Atlantis-xyc/smart-screen-t113/切片 68.png

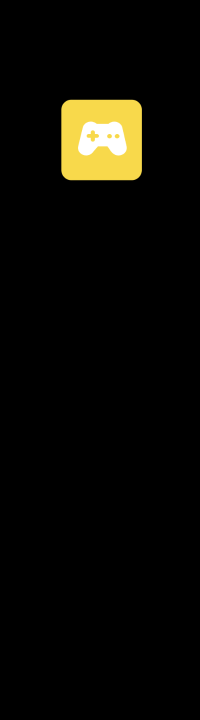
切片 68.png
