Atlantis-xyc/smart-screen-t113/素材/image (3).png

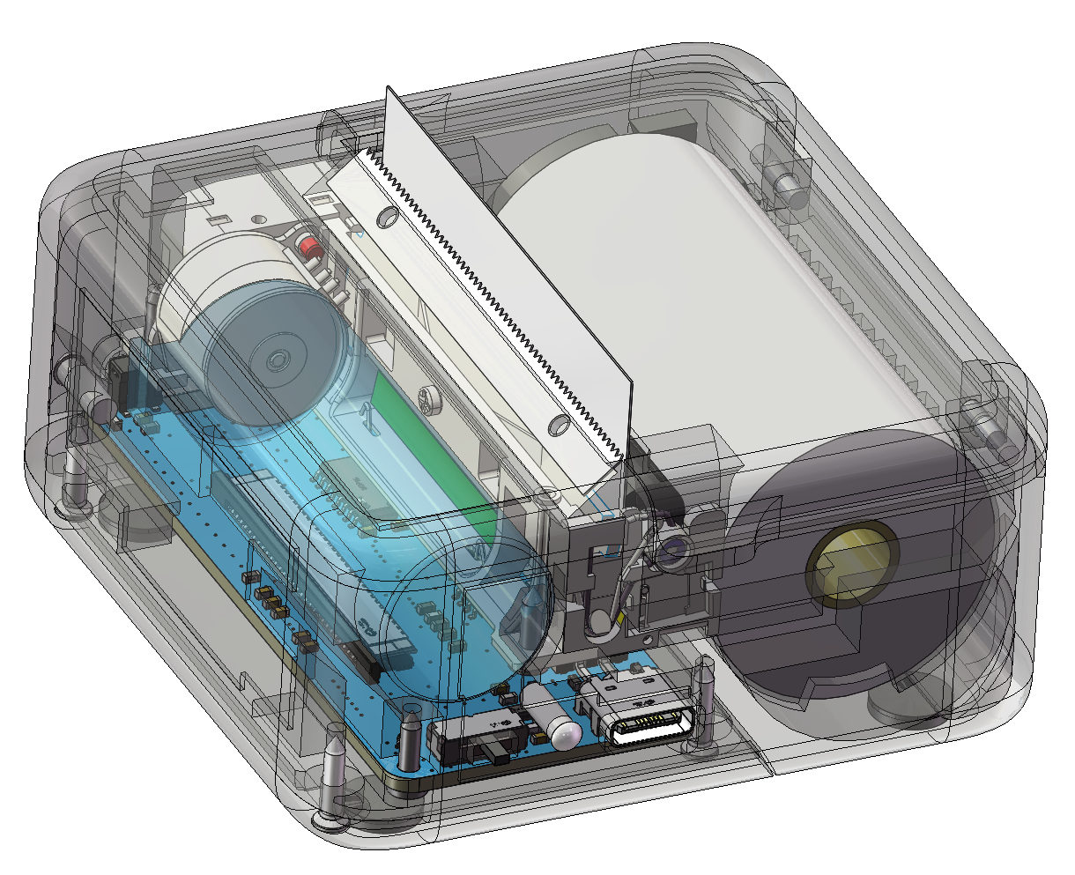
素材/image (3).png
