Atlantis-xyc/smart-screen-t113/素材/image (4).png

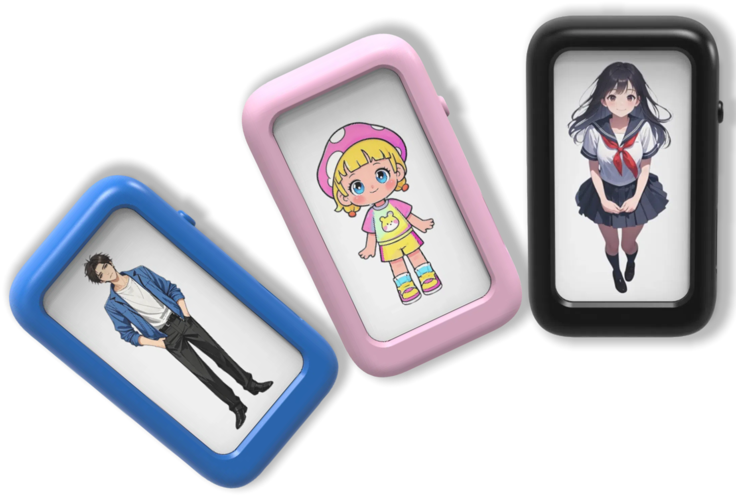
素材/image (4).png
