Atlantis-xyc/smart-screen-t113/素材/image (5).png

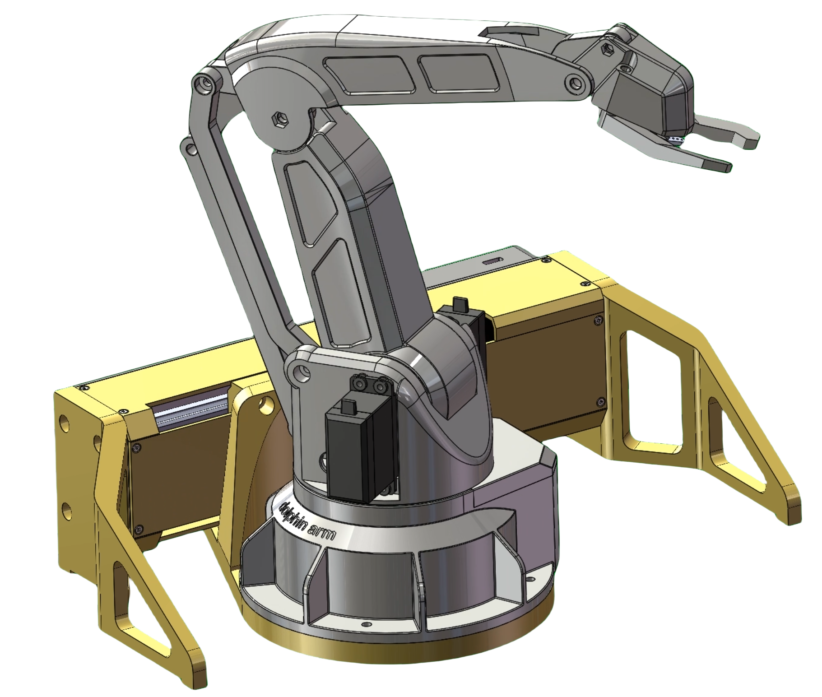
素材/image (5).png
