Atlantis-xyc/smart-screen-t113/素材/PixPin_2025-08-05_22-09-04.png

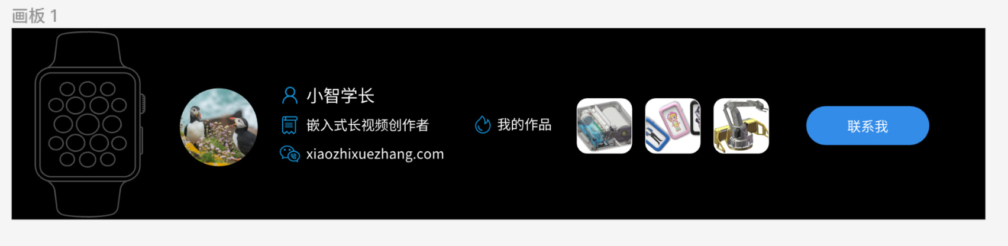
素材/PixPin_2025-08-05_22-09-04.png
