Atlantis-xyc/smart-screen-t113/素材/介绍.png

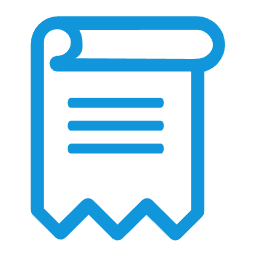
素材/介绍.png
