Atlantis-xyc/smart-screen-t113/素材/热门作品.png

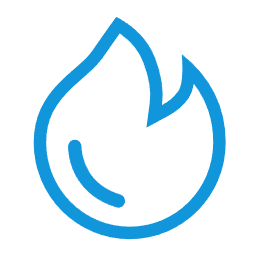
素材/热门作品.png
