Atlantis-xyc/smart-screen-t113/素材/用户.png

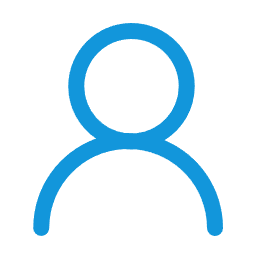
素材/用户.png
