Atlantis-xyc/smart-screen-t113/素材/联系方式.png

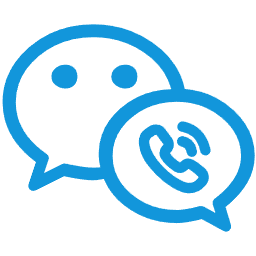
素材/联系方式.png
