Atlantis-xyc/smart-screen-t113/BOM_Board1_MIPI_PCB_2025-10-30.xlsx

No. | Quantity | Comment | Designator | Footprint | Value | Manufacturer Part | Manufacturer | Supplier Part | Supplier
1 | 22 | 100nF | C1,C12,C14,C15,C16,C17,C19,C21,C29,C30,C34,C36,C37,C38,C41,C63,C85,C86,C91,C116,C124,C135 | C0603 | 100nF | CC0603KRX7R9BB104 | YAGEO(国巨) | C14663 | LCSC
2 | 6 | 10uF | C9,C13,C27,C28,C31,C33 | C0603 | 10uF | CL10A106KP8NNNC | SAMSUNG(三星) | C19702 | LCSC
3 | 13 | 10uF | C64,C65,C107,C108,C109,C110,C111,C112,C115,C139,C143,C144,C145 | C0603 | 10uF | CL10A106MA8NRNC | SAMSUNG(三星) | C96446 | LCSC
4 | 3 | 470nF | C82,C83,C142 | C0603 | 470nF | CL10B474KA8NNNC | SAMSUNG(三星) | C1623 | LCSC
5 | 1 | 100pF | C87 | C0603 | 100pF | CL10C101JB8NNNC | SAMSUNG(三星) | C14858 | LCSC
6 | 1 | 2.2uF | C88 | C0603 | 2.2uF | CL10A225KO8NNNC | SAMSUNG(三星) | C23630 | LCSC
7 | 4 | 1uF | C119,C133,C138,C141 | C0603 | 1uF | CL10A105KB8NNNC | SAMSUNG(三星) | C15849 | LCSC
8 | 4 | 12pF | C120,C121,C122,C123 | C0603 | 12pF | CC0603FRNPO9BN120 | YAGEO(国巨) | C519482 | LCSC
9 | 1 | 22uF | C132 | C0603 | 22uF | CL10A226MQ8NRNC | SAMSUNG(三星) | C59461 | LCSC
10 | 1 | HC-1.25-2PWT | CN2 | CONN-SMD_2P-P1.25-HC-1.25-2PWT |  | HC-1.25-2PWT | HCTL(华灿天禄) | C2845379 | LCSC
11 | 2 | LMBR240FT1G | D22,D23 | SOD-123FL_L2.7-W1.8-LS3.8-RD |  | LMBR240FT1G | LRC(乐山无线电) | C383230 | LCSC
12 | 1 | FPC-05F-30PH20 | FPC2 | FPC-SMD_30P-P0.50_XUNPU_FPC-05F-30PH20 |  | FPC-05F-30PH20 | XUNPU(讯普) | C2856808 | LCSC
13 | 1 | AFC07-S06ECA-00 | FPC7 | FPC-SMD_P0.50-6P_LCS-SJ-H2.0 |  | AFC07-S06ECA-00 | JS(钜硕电子) | C262579 | LCSC
14 | 1 | GZ1608D601TF | L8 | L0603 | 600Ω | GZ1608D601TF | Sunlord(顺络) | C1002 | LCSC
15 | 1 | AN2051-245 | L10 | ANT2051 |  | AN2051-245 | rainsun(霖昱微) | C99727 | LCSC
16 | 1 | 10uH | L18 | IND-SMD_L2.0-W1.6 | 10uH | WPN201610H100MT | Sunlord(顺络) | C89132 | LCSC
17 | 4 | 2.2uH | L20,L21,L22,L23 | L0805 | 2.2uH | MGFL2012F2R2MT-LF | microgate(麦捷科技) | C281115 | LCSC
18 | 2 | NCD0603B1 | LED3,LED4 | LED0603-RD |  | NCD0603B1 | 国星光电 | C84266 | LCSC
19 | 1 | GMI4015P-2C-42db | MIC2 | MIC-TH_BD4.0-P1.40-D0.4-L-FD |  | GMI4015P-2C-42db | INGHAi(赢海) | C233292 | LCSC
20 | 10 | 10kΩ | R13,R52,R91,R93,R115,R120,R122,R124,R126,R145 | R0603 | 10kΩ | 0603WAF1002T5E | UNI-ROYAL(厚声) | C25804 | LCSC
21 | 1 | 10MΩ | R14 | R0603 | 10MΩ | 0603WAF1005T5E | UNI-ROYAL(厚声) | C7250 | LCSC
22 | 1 | 0Ω | R79 | R0603 | 0Ω | 0603WAF0000T5E | UNI-ROYAL(厚声) | C21189 | LCSC
23 | 1 | 33Ω | R90 | R0603 | 33Ω | 0603WAF330JT5E | UNI-ROYAL(厚声) | C23140 | LCSC
24 | 3 | 150kΩ | R107,R110,R152 | R0603 | 150kΩ | 0603WAF1503T5E | UNI-ROYAL(厚声) | C22807 | LCSC
25 | 1 | 680kΩ | R108 | R0603 | 680kΩ | 0603WAF6803T5E | UNI-ROYAL(厚声) | C25822 | LCSC
26 | 3 | 300kΩ | R109,R112,R153 | R0603 | 300kΩ | 0603WAF3003T5E | UNI-ROYAL(厚声) | C23024 | LCSC
27 | 1 | 200kΩ | R111 | R0603 | 200kΩ | 0603WAF2003T5E | UNI-ROYAL(厚声) | C25811 | LCSC
28 | 4 | 5.1kΩ | R113,R114,R141,R142 | R0603 | 5.1kΩ | 0603WAF5101T5E | UNI-ROYAL(厚声) | C23186 | LCSC
29 | 1 | 10Ω | R121 | R0603 | 10Ω | 0603WAF100JT5E | UNI-ROYAL(厚声) | C22859 | LCSC
30 | 1 | 240Ω | R123 | R0603 | 240Ω | 0603WAF2400T5E | UNI-ROYAL(厚声) | C23350 | LCSC
31 | 1 | 22Ω | R135 | R0603 | 22Ω | 0603WAF220JT5E | UNI-ROYAL(厚声) | C23345 | LCSC
32 | 2 | 20kΩ | R136,R149 | R0603 | 20kΩ | 0603WAF2002T5E | UNI-ROYAL(厚声) | C4184 | LCSC
33 | 1 | 100kΩ | R138 | R0603 | 100kΩ | 0603WAF1003T5E | UNI-ROYAL(厚声) | C25803 | LCSC
34 | 2 | 1kΩ | R146,R147 | R0603 | 1kΩ | 0603WAF1001T5E | UNI-ROYAL(厚声) | C21190 | LCSC
35 | 1 | 75Ω | R148 | R0603 | 75Ω | 0603WAF750JT5E | UNI-ROYAL(厚声) | C4275 | LCSC
36 | 3 | 10kΩ | RN1,RN2,RN3 | RES-ARRAY-SMD_0603-8P-L3.2-W1.6-BL | 10kΩ | 4D03WGJ0103T5E | UNI-ROYAL(厚声) | C29718 | LCSC
37 | 3 | TS-1088-AR02016 | SW1,SW2,SW5 | SW-SMD_L3.9-W3.0-P4.45 |  | TS-1088-AR02016 | XUNPU(讯普) | C720477 | LCSC
38 | 1 | T113_S3 | T1 | TQFP-128_L14.0-W14.0-P0.40-LS16.0-BL-EP6.4 |  |  |  |  | 全志
39 | 1 | W25N01GVZEIG | U1 | WSON-8_L8.0-W6.10-P1.27-BL-EP |  | W25N01GVZEIG | WINBOND(华邦) | C907680 | LCSC
40 | 1 | MX02 | U5 | MX02
41 | 1 | RTL8723DS模块 | U11 | WIFIM-SMD_44P-L12.0-W12.0-P0.90_RTL8723DS |  | RTL8723DS模块 |  | C2920724 | LCSC
42 | 11 | ESD5451N | U21,U33,U34,U35,U36,U37,U38,U41,U42,U49,U50 | X1-DFN1006-2_L1.0-W0.6-P0.65-BI |  | ESD5451N | TECH PUBLIC(台舟) | C2936977 | LCSC
43 | 1 | ZX-MX1.25-3PWT | U24 | CONN-SMD_3P-P1.25_MEGASTAR_ZX-MX1.25-3PWT |  | ZX-MX1.25-3PWT | Megastar(兆星) | C7430469 | LCSC
44 | 4 | SY8088AAC | U27,U28,U29,U54 | SOT-23-5_L3.0-W1.7-P0.95-LS2.8-BR |  | SY8088AAC | silergy(矽力杰) | C79313 | LCSC
45 | 1 | MT9201 | U52 | SOT-23-6_L2.9-W1.6-P0.95-LS2.8-BR |  | MT9201 | 西安航天民芯 | C182966 | LCSC
46 | 1 | LM4871 | U53 | SOIC-8_L4.9-W3.9-P1.27-LS6.0-BL |  | LM4871 | IDCHIP(英锐芯) | C7494970 | LCSC
47 | 2 | KH-TYPE-C-16P | USB9,USB10 | usb-c-smd_kh-type-c-16p |  | KH-TYPE-C-16P | kinghelm(金航标) | C709357 | LCSC
48 | 1 | XL2EL89COI-111YLC-24M | X1 | CRYSTAL-SMD_4P-L3.2-W2.5-BL |  | XL2EL89COI-111YLC-24M | YXC(扬兴晶振) | C5444545 | LCSC
49 | 1 | 32.768kHz | X2 | OSC-SMD_L3.2-W1.5 | 32.768kHz | X321532768KGD2SI | YXC(扬兴晶振) | C620155 | LCSC
