Atlantis-xyc/smart-screen-t113/SCH_Schematic_2026-05-21.pdf

T113S3

# 外围电容

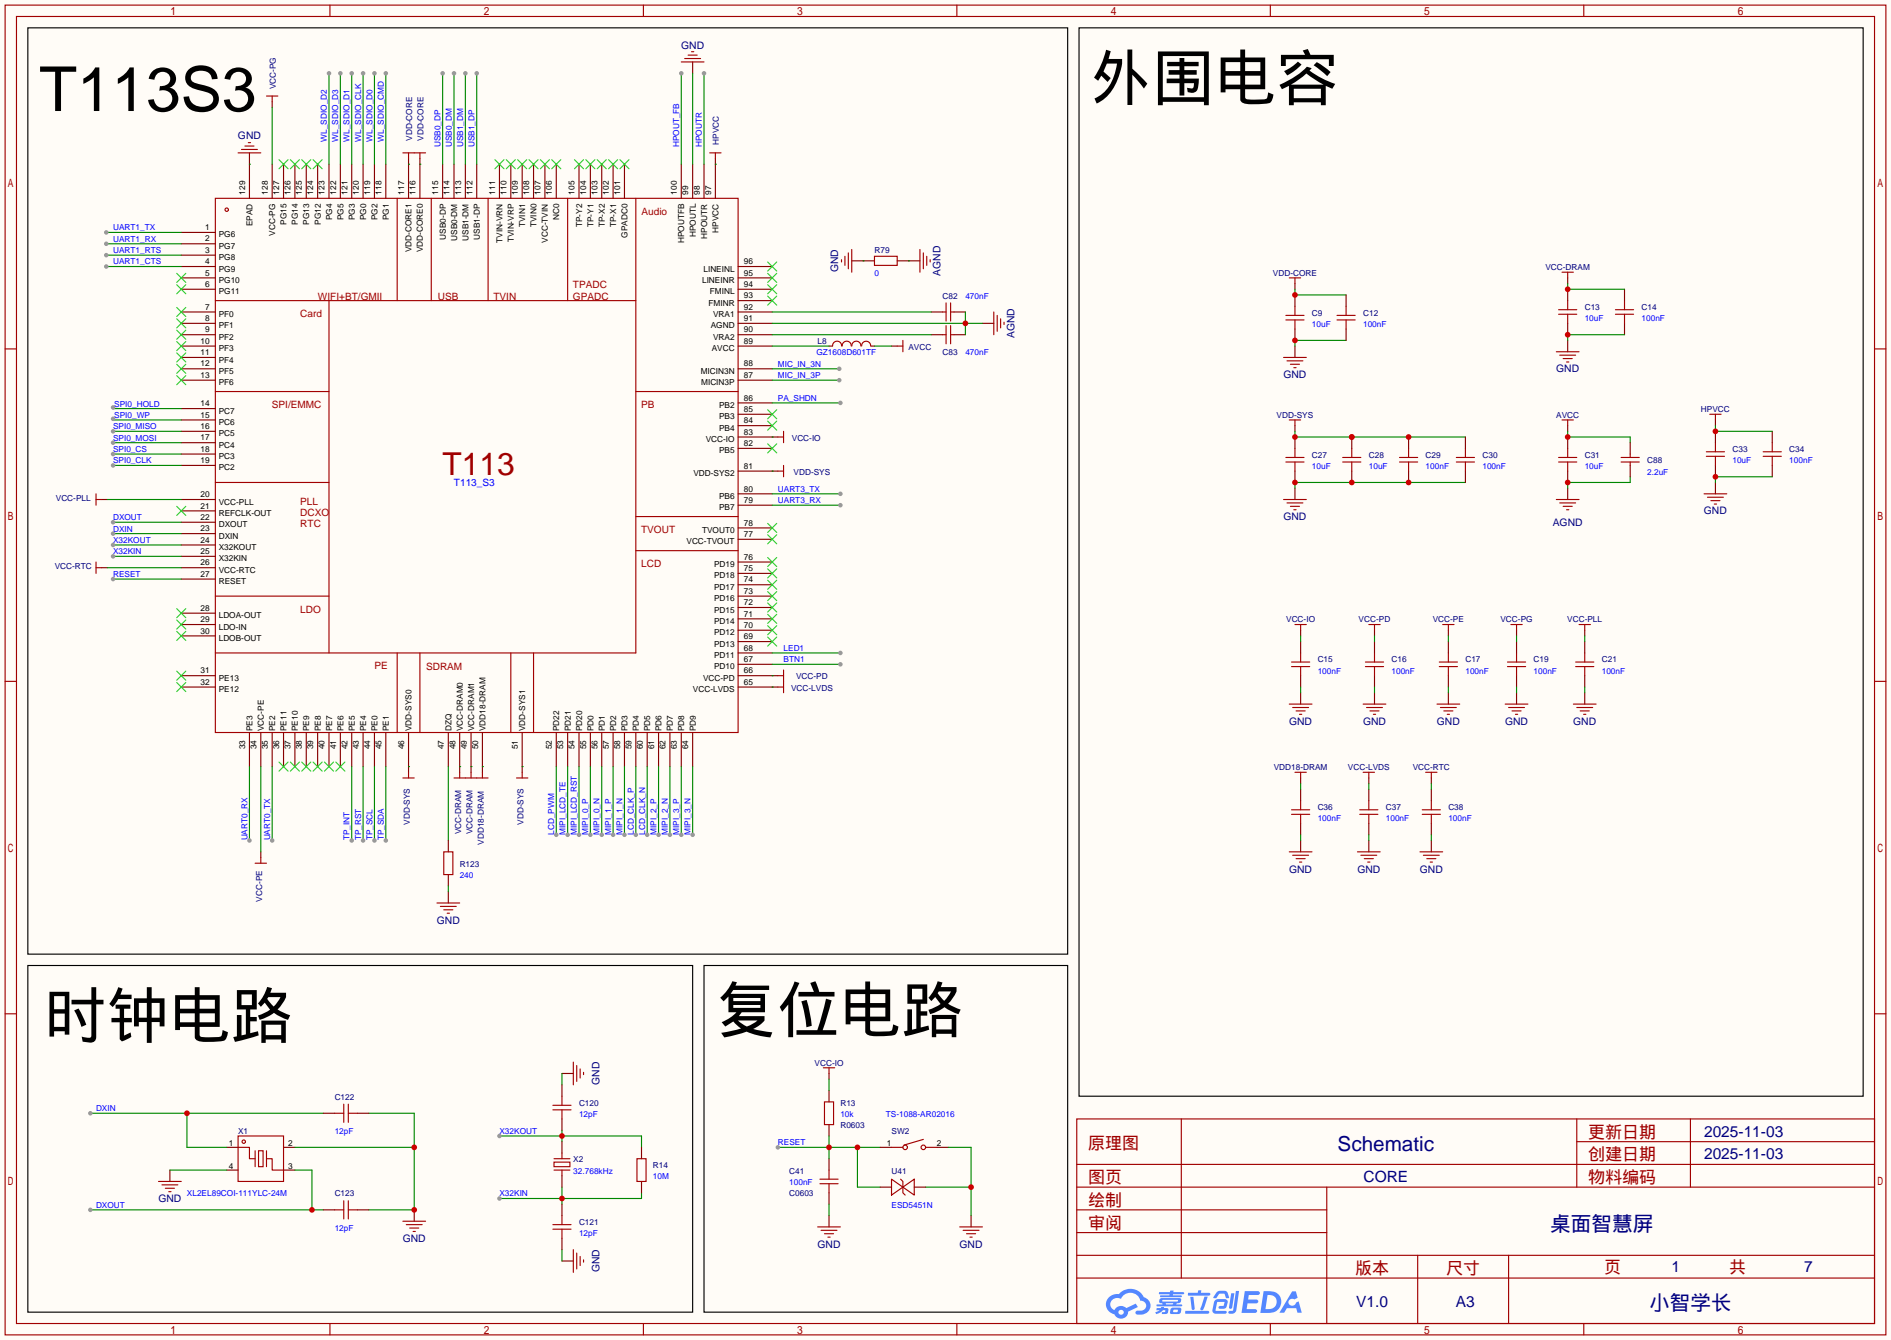
[picture p25: page 1]

# BLE MESH

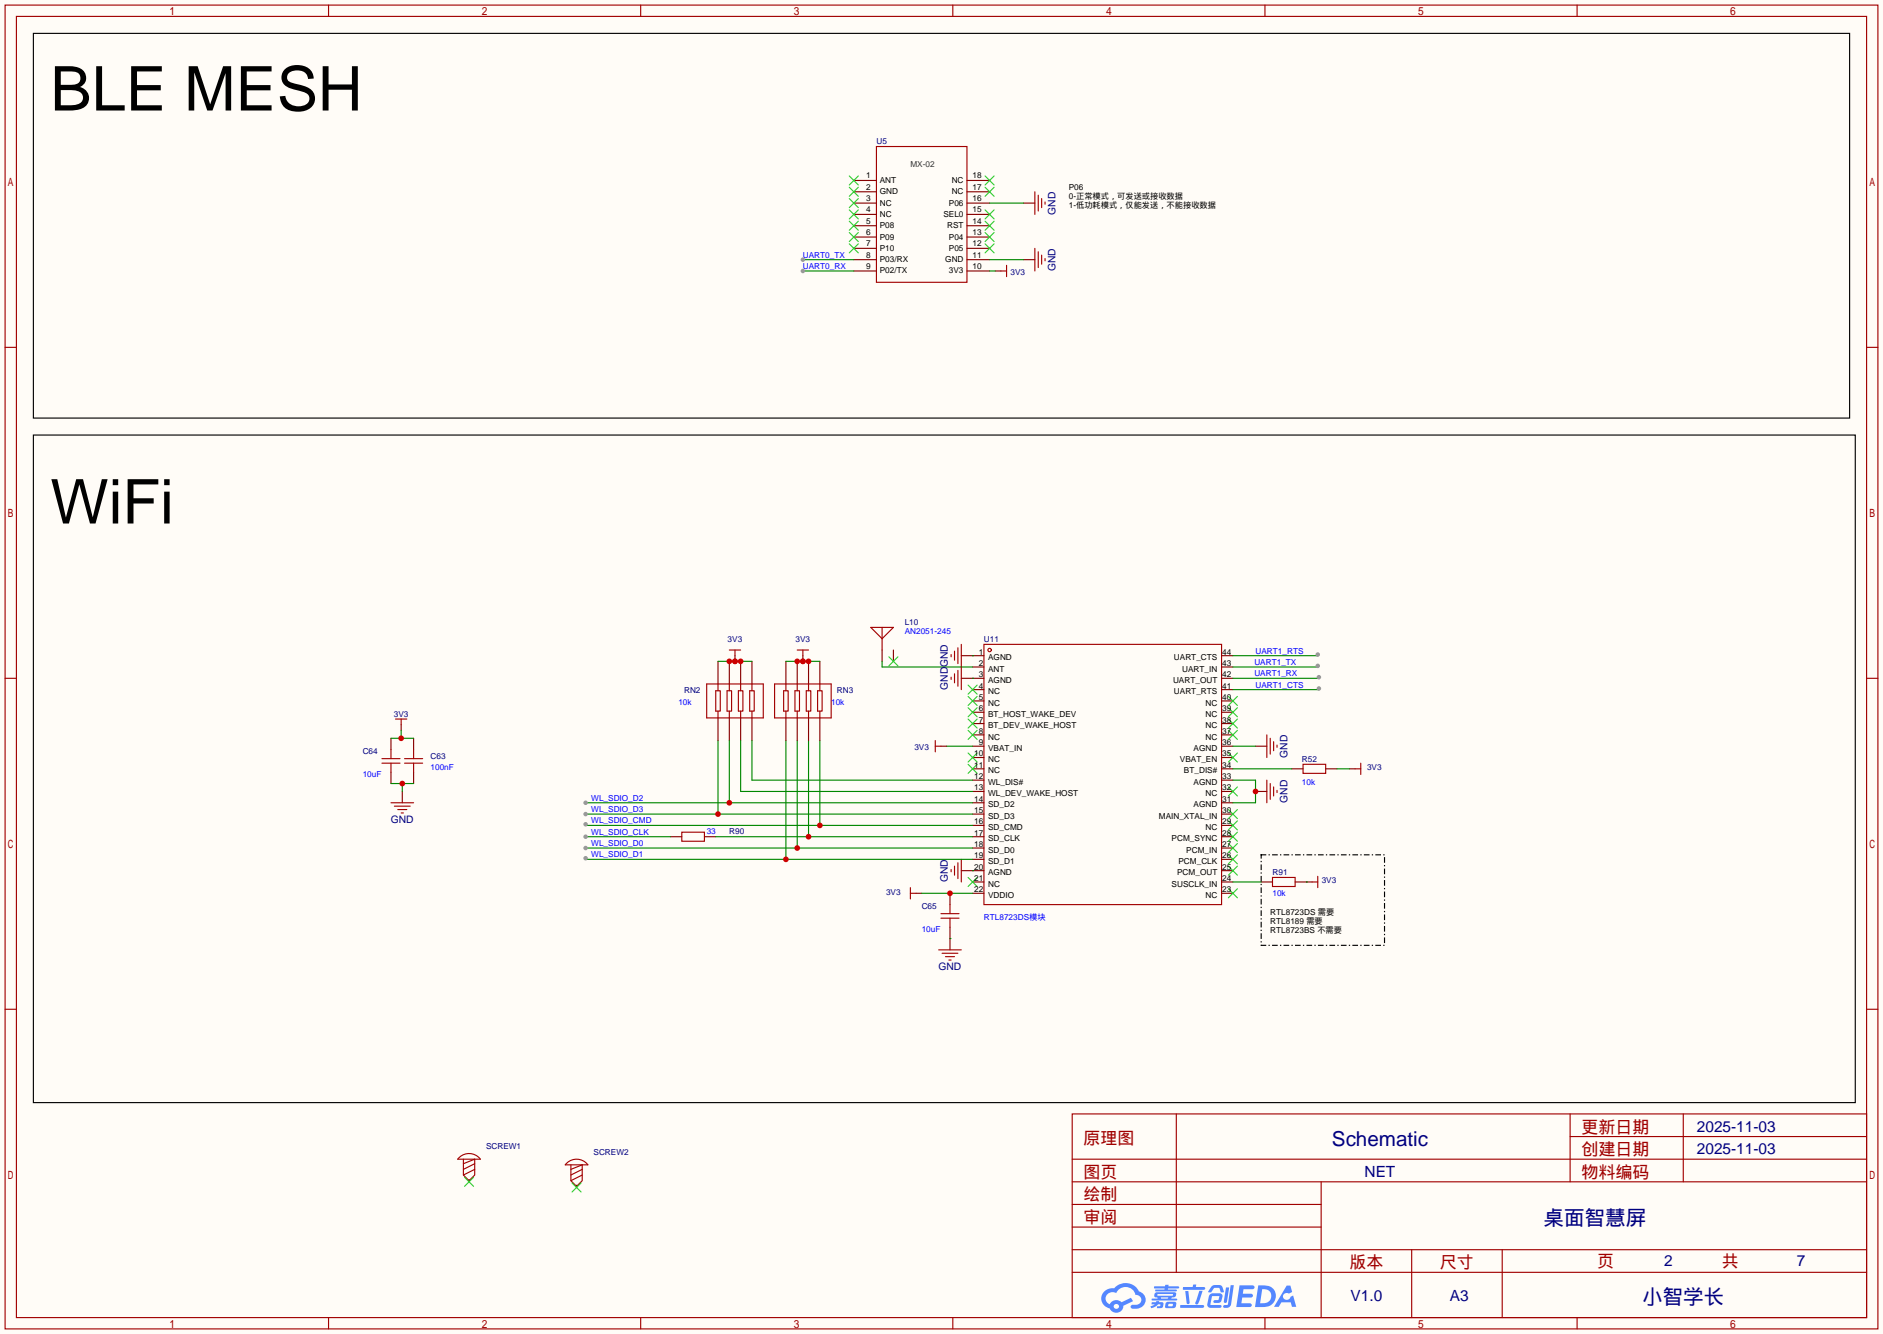
[picture p26: page 2]

# 5V转3.3V

# 电源模块

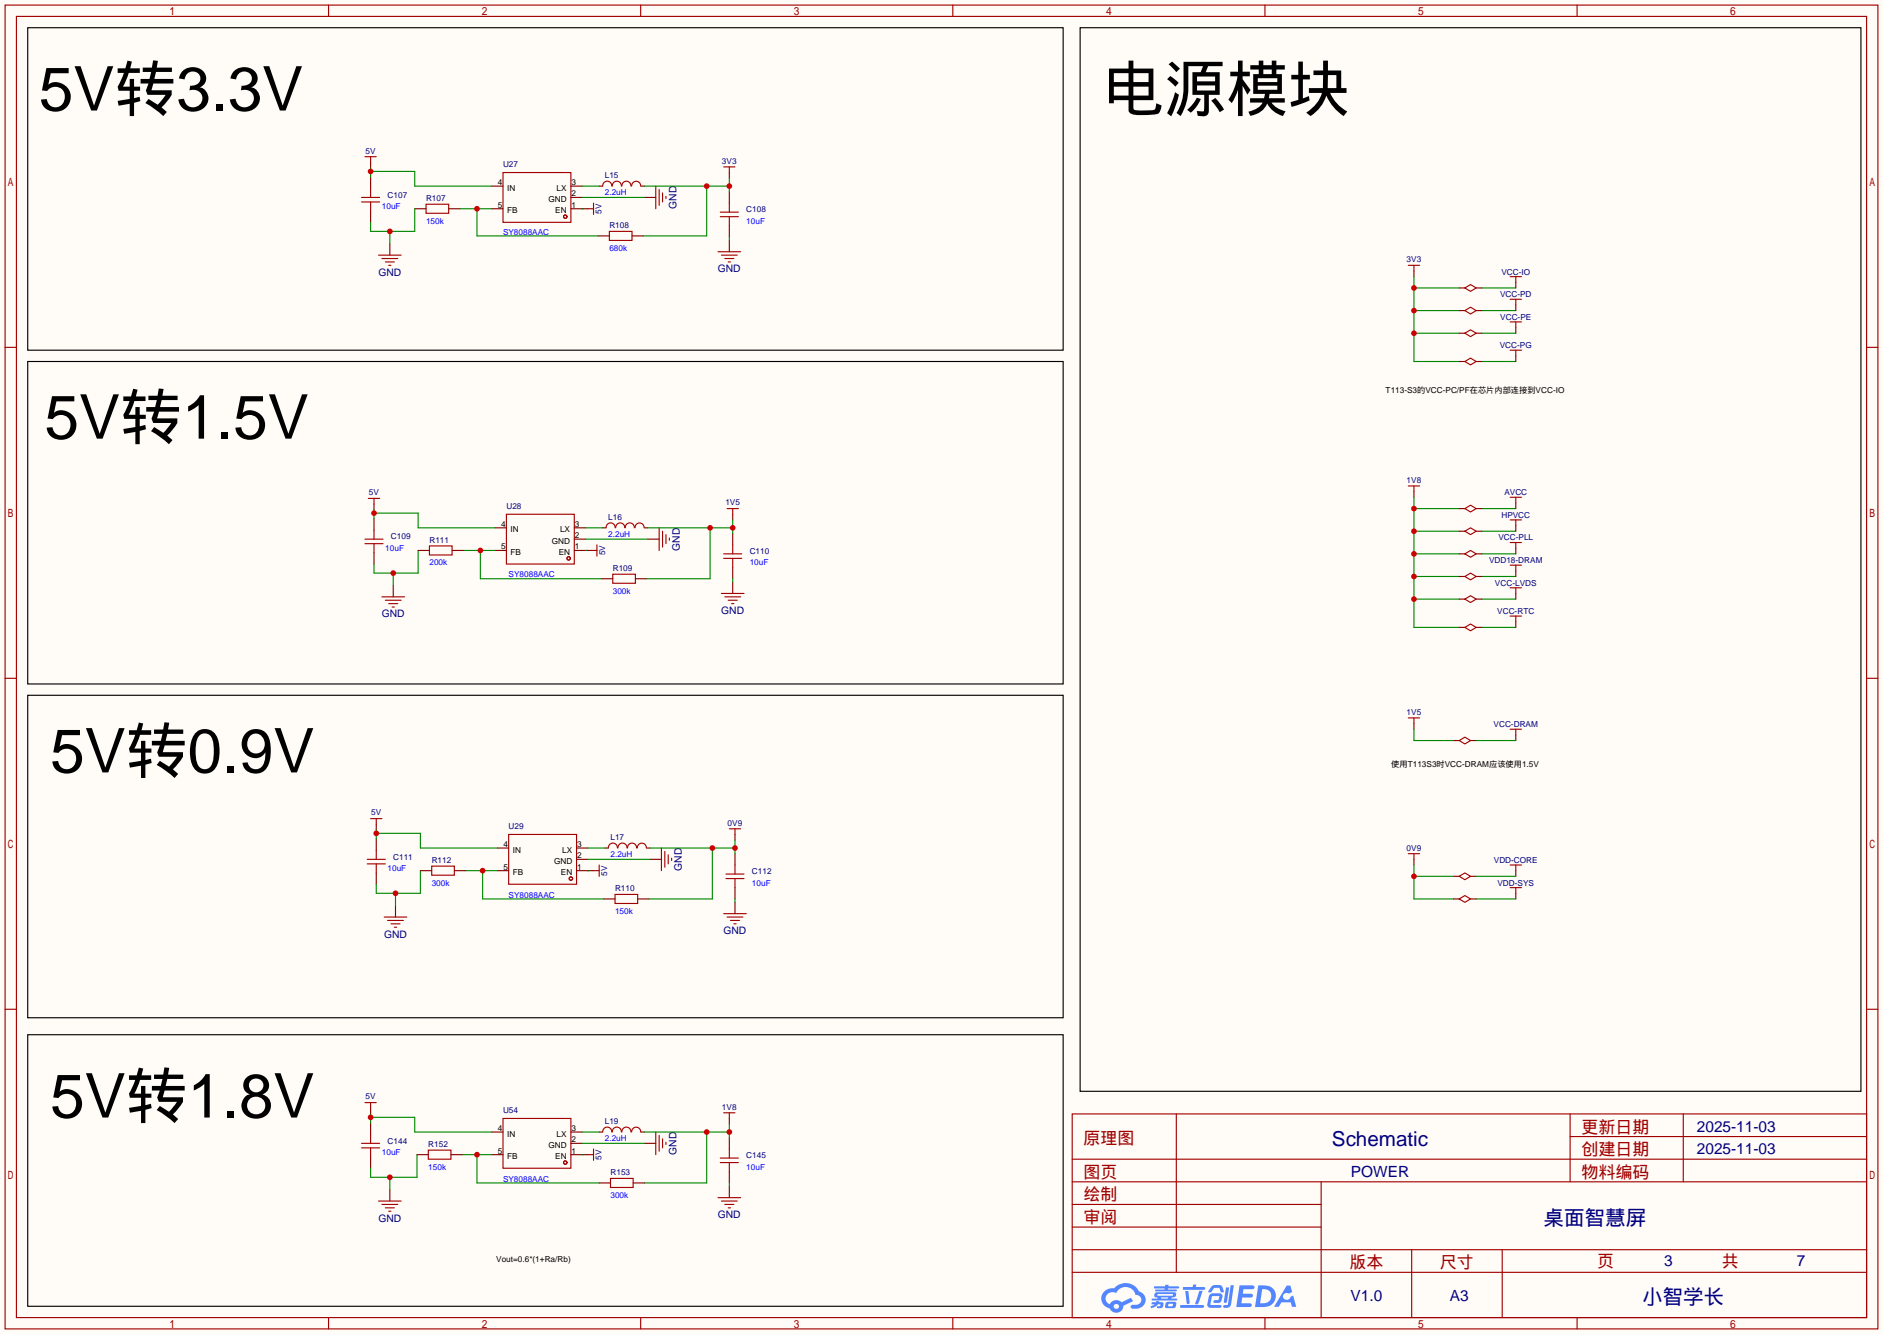
[picture p27: page 3]

# 供电Typec

# 电源指示灯

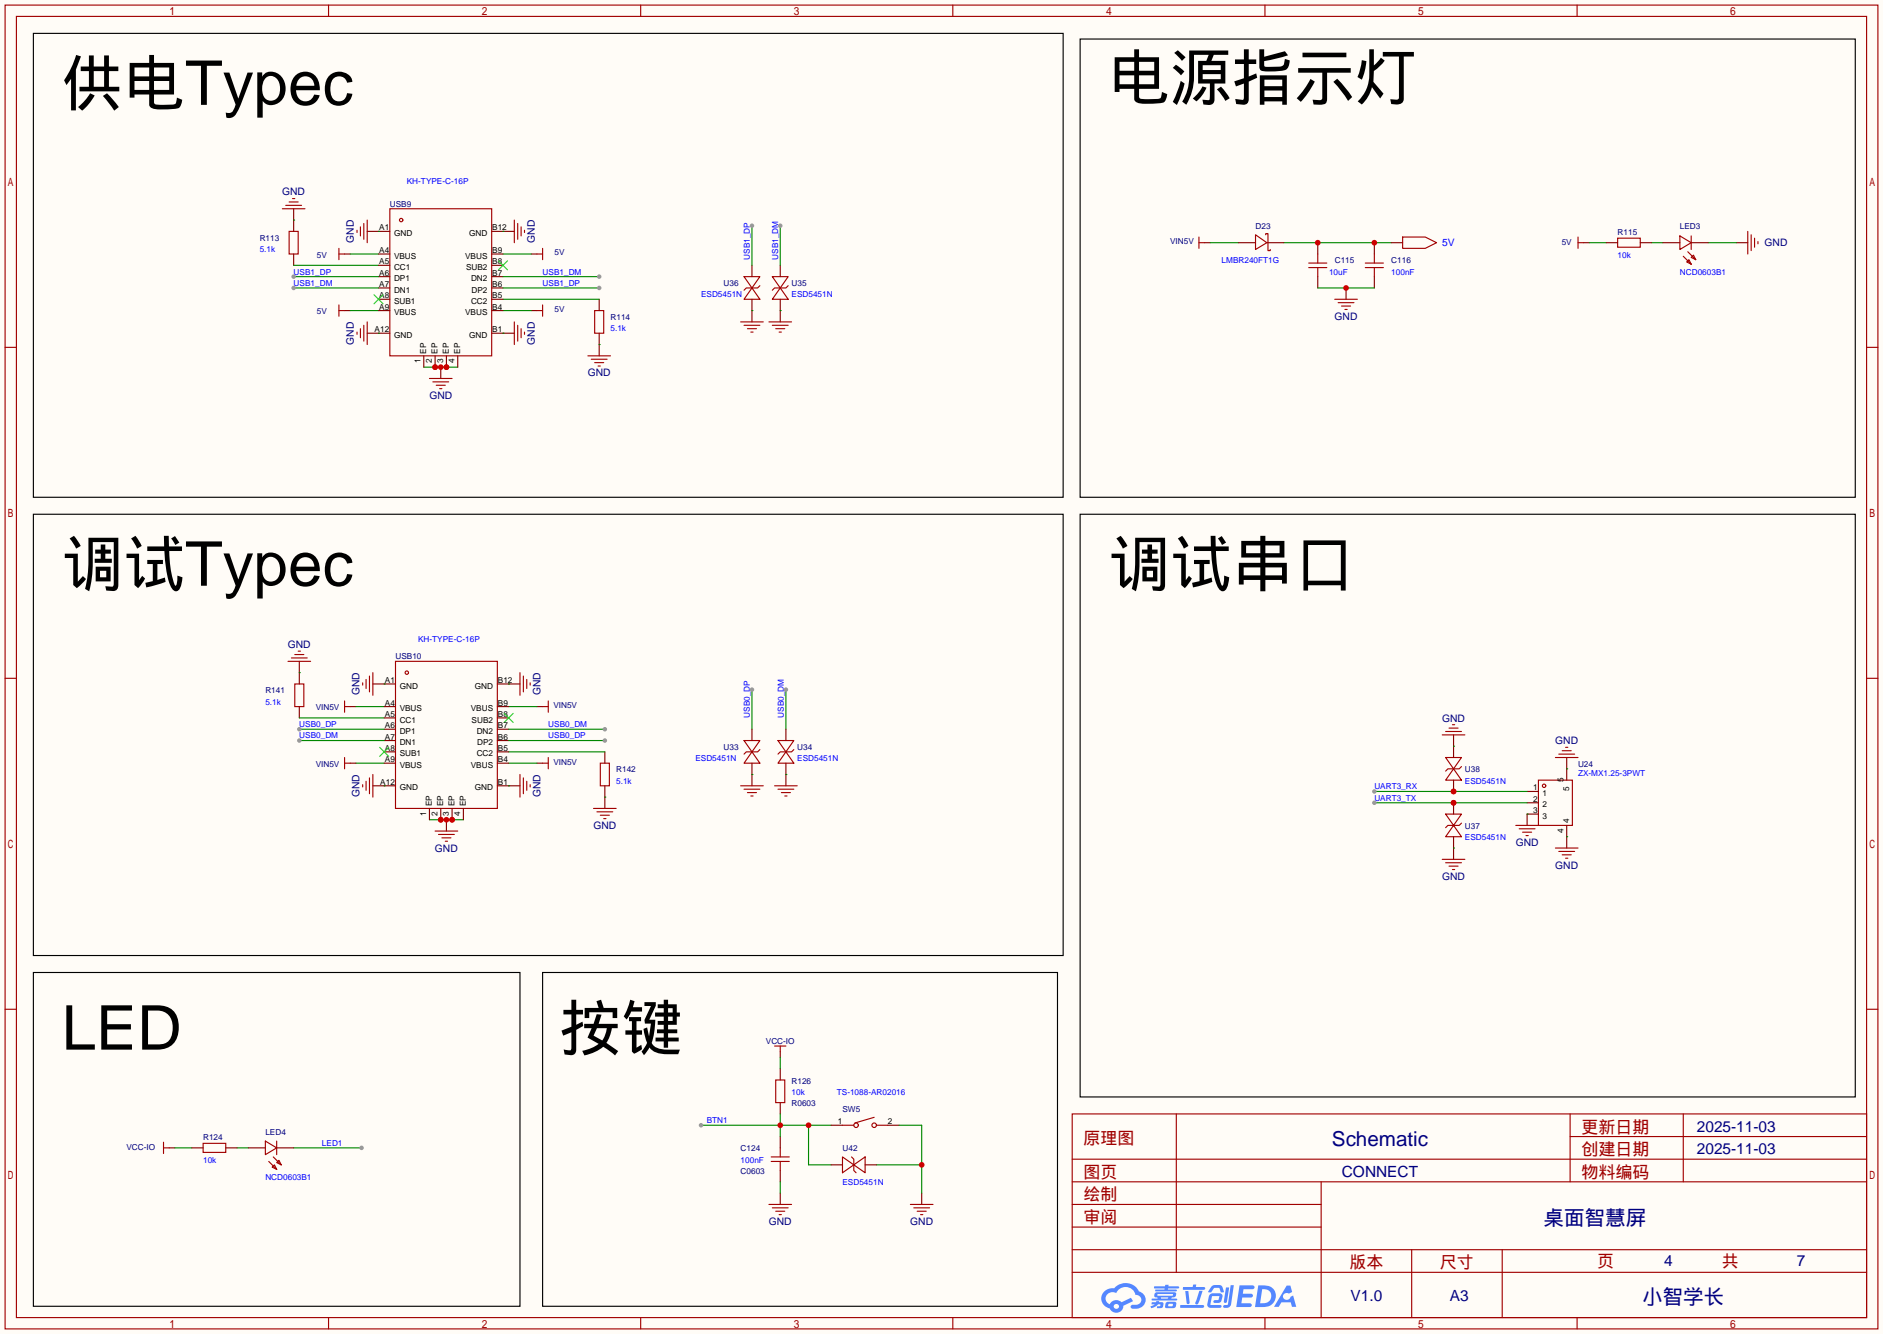
[picture p28: page 4]

# MIC

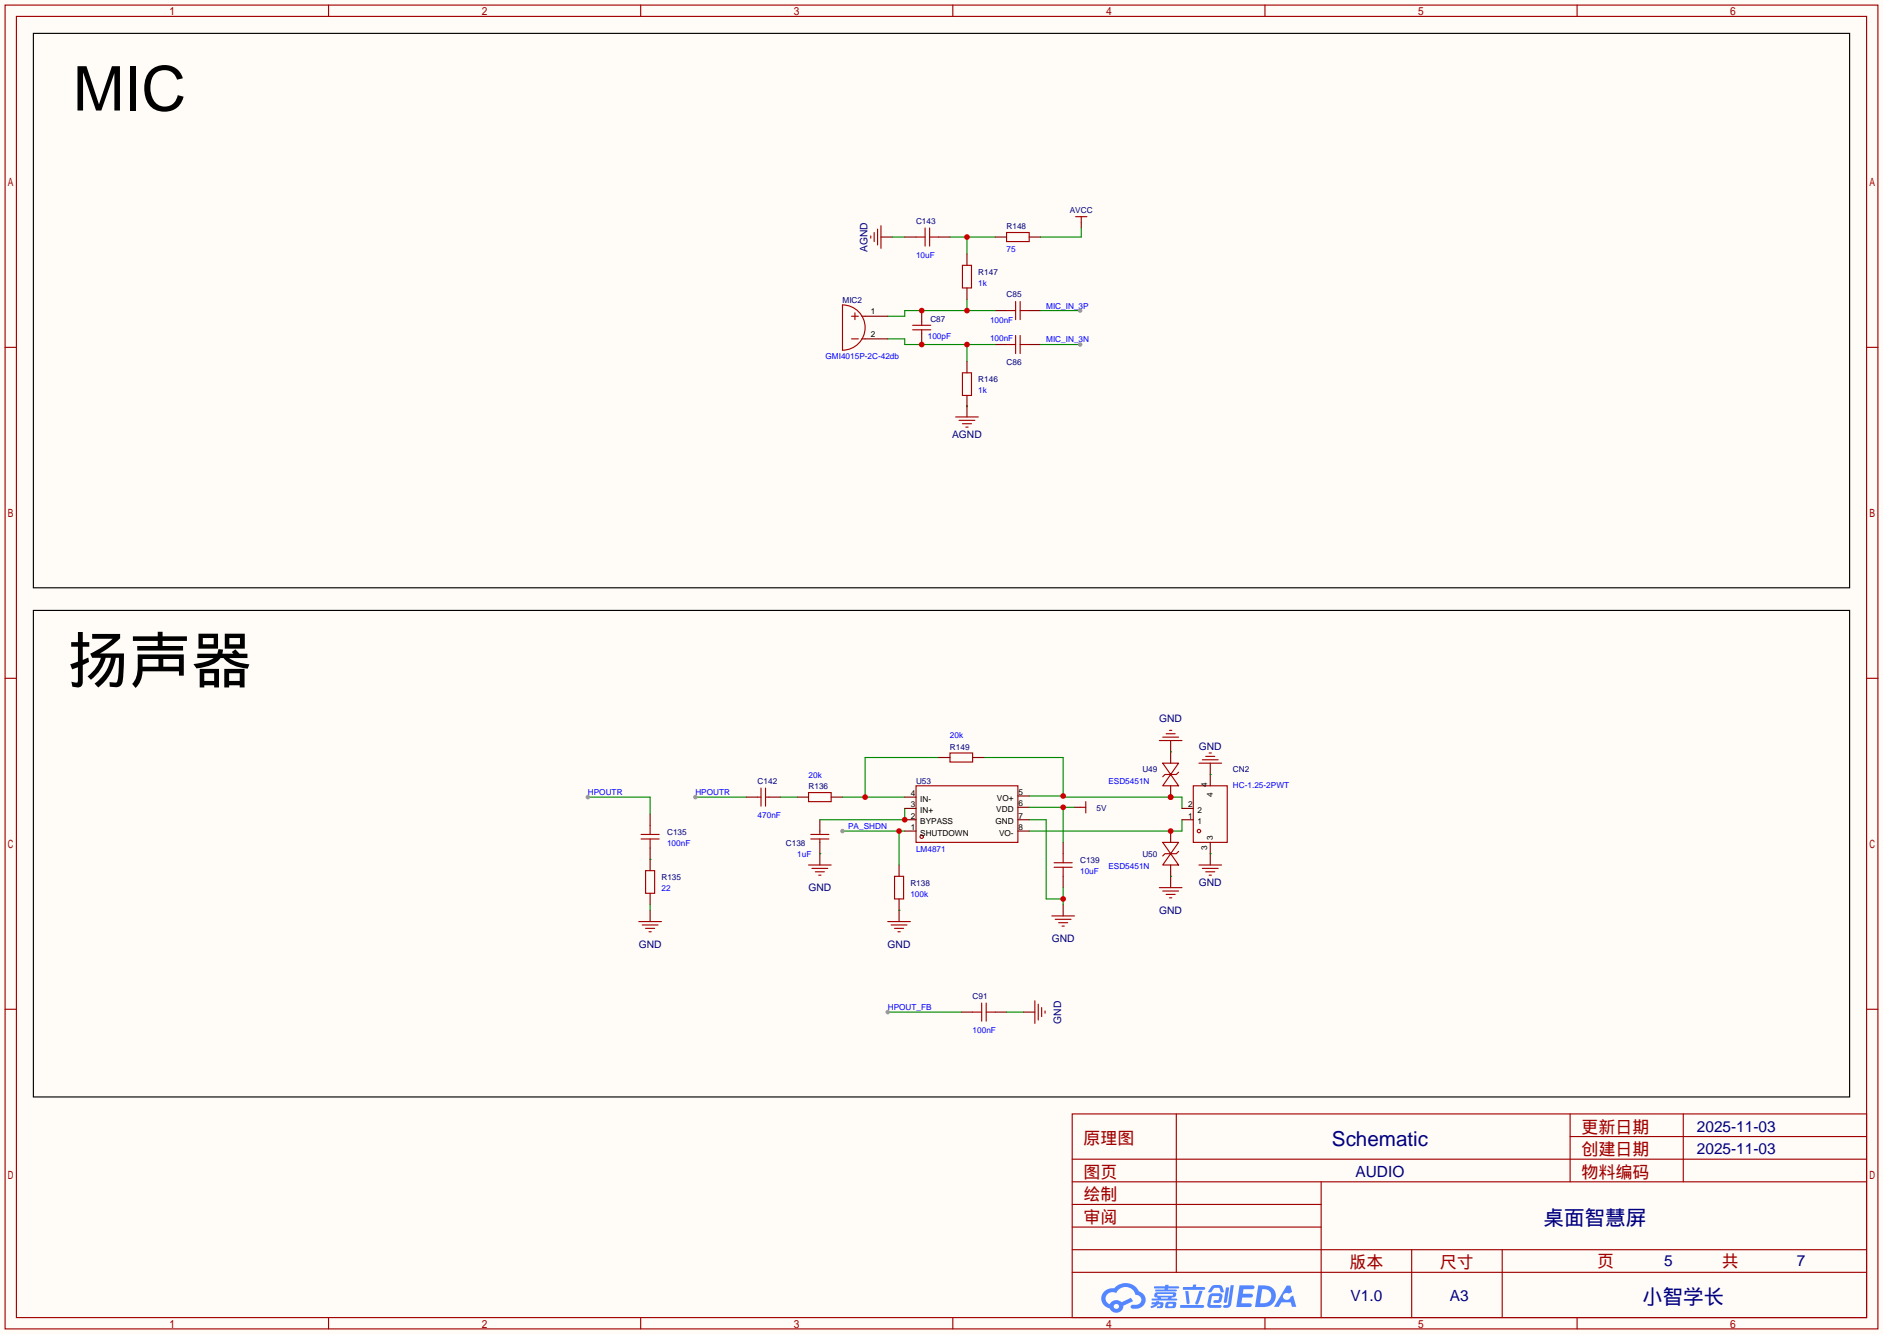
[picture p29: page 5]

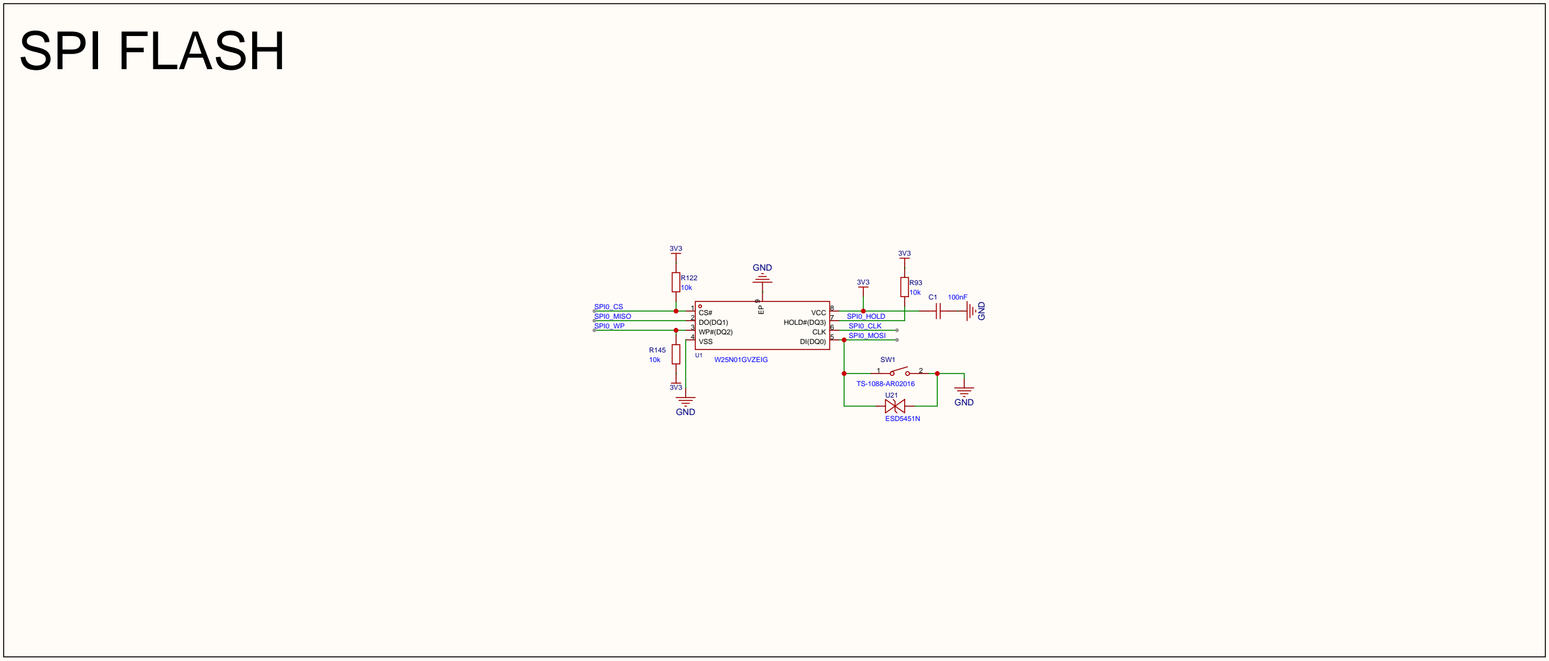
[picture p30: figure]
CS# 1 DO(DQ1) 2 WP#(DQ2) 3 VSS 4; CLK 6; HOLD#(DQ3) 7; VCC 8; W25N01GVZEIG; SPI0_CS SPI0_MISO; GND; SPI0_MOSI; SPI0_WP; SPI0_CLK; SPI0_HOLD; ESD5451N; SPI FLASH

审阅

绘制

## 创建日期 物料编码

## 原理图

## 更新日期

图页

# 桌面智慧屏

2025-11-03

# 2025-11-03 Schematic

# FLASH

# MIPI屏幕 I2C触摸

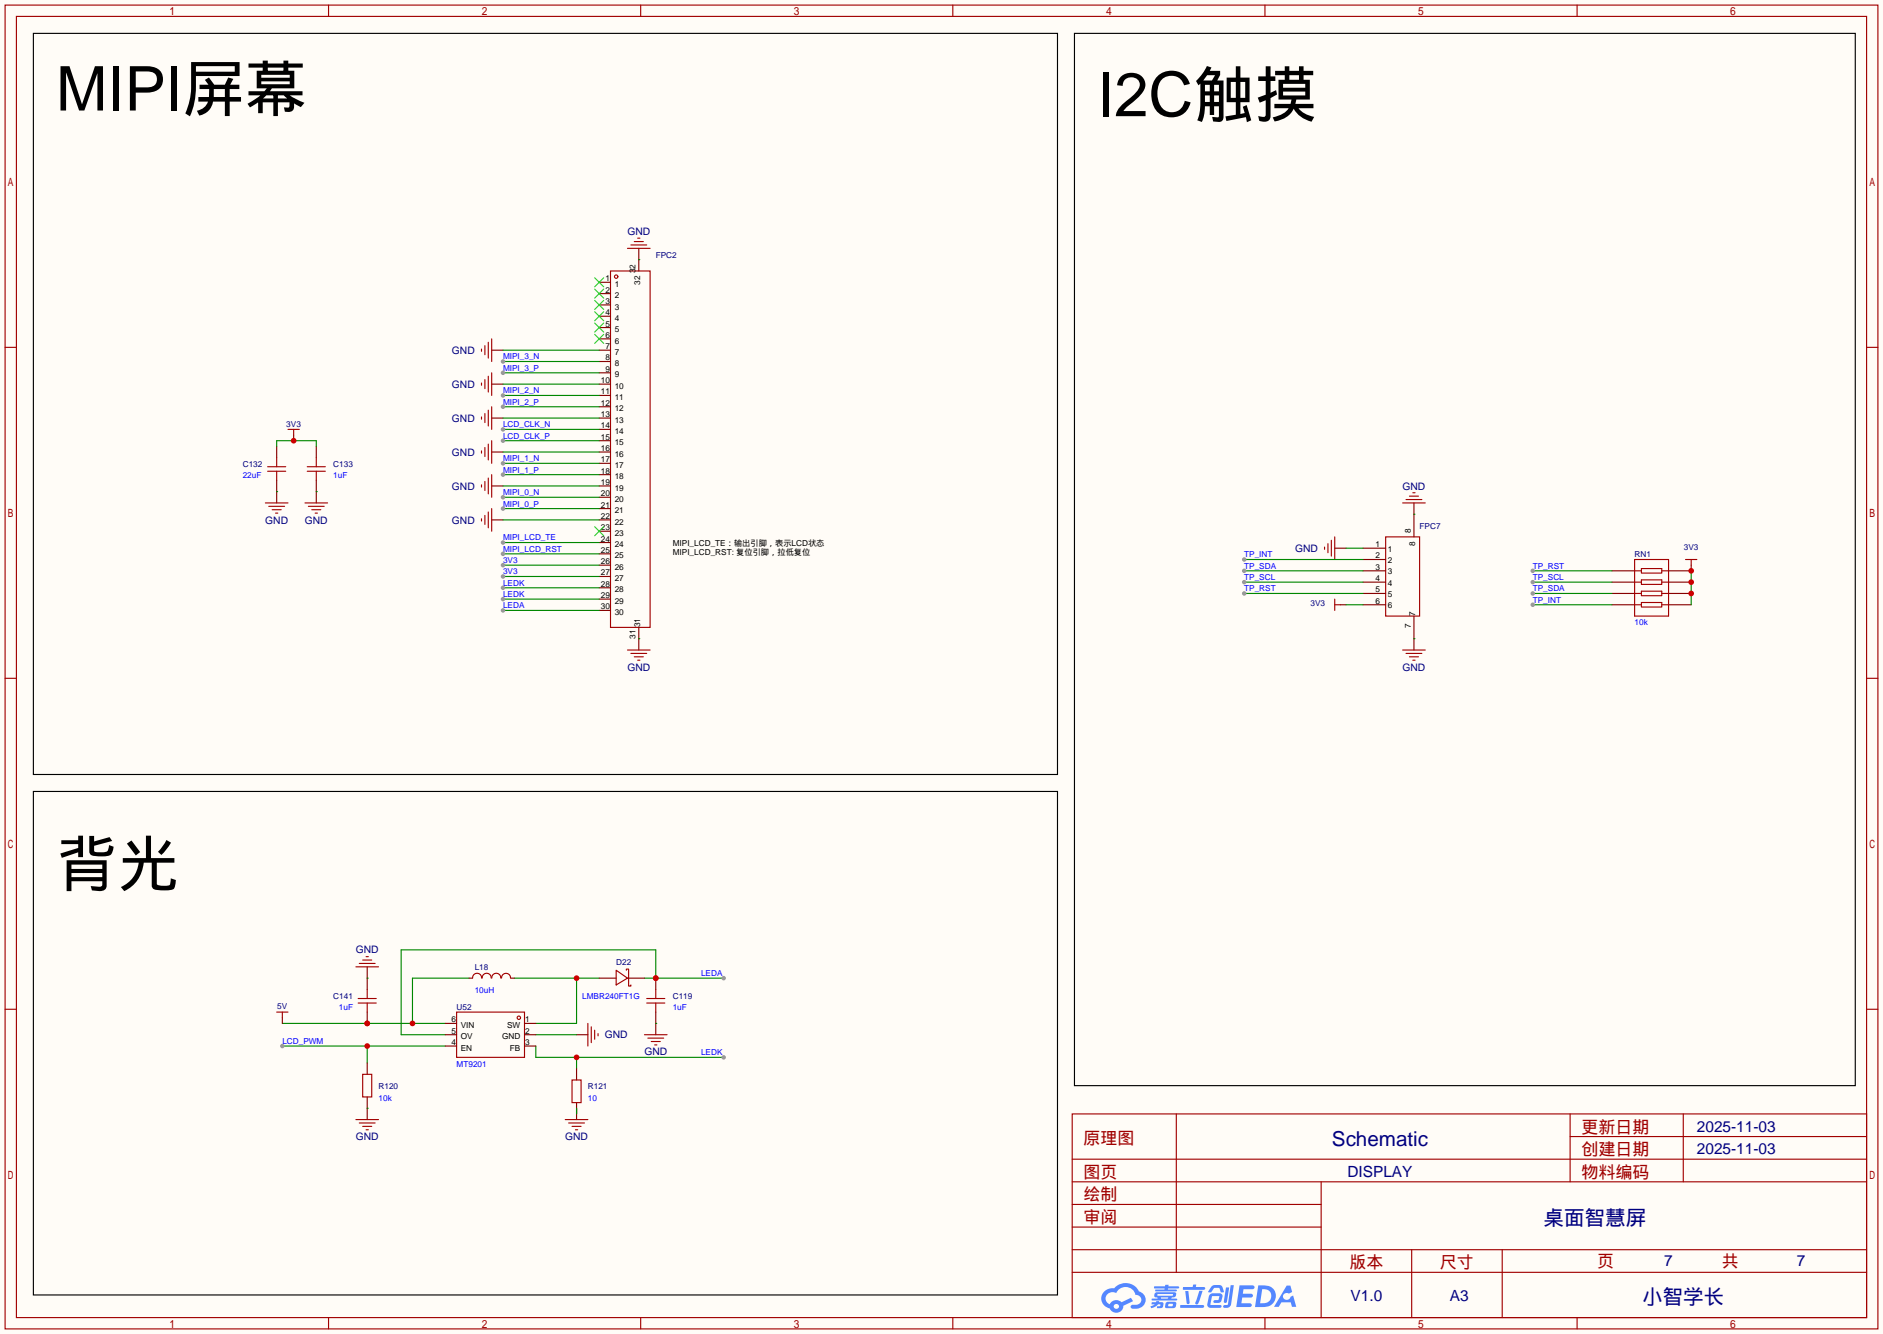
[picture p31: page 7]
