Atlantis-xyc/smart-screen-t113/(list of files, drawings)

Other design files:
ProPrj_Smart_Screen_T113_end_2025-07-25.epro
ProPrj_Smart_Screen_T113_PCB6.epro
