Atlantis-xyc/smart-screen-t113/app4/main.c

#include <unistd.h>
#include <stdlib.h>
#include <stdio.h>
#include "lvgl.h"
#include "font_conf.h"
#include "page_conf.h"

extern void lv_port_disp_init(bool is_disp_orientation);
extern void lv_port_indev_init(void);

int main() {
    //LVGL框架初始化
    lv_init();
    //LVGL显示屏幕初始化
    lv_port_disp_init(true);
    //LVGL输入设备初始化
    lv_port_indev_init();
    
    font_init();
    init_page_test();

    while (1) {
        lv_task_handler();
        //延时，保证cpu占有率不会过高
        usleep(1000);
    }
    return 0;
}
