Atlantis-xyc/smart-screen-t113/(commit log)

2026-07-15 初始提交:T113 桌面智慧屏项目(硬件设计、应用源码、UI 资源)
    [BOM_Board1_MIPI_PCB_2025-10-30.xlsx, ProPrj_Smart_Screen_T113_PCB6.epro, ProPrj_Smart_Screen_T113_end_2025-07-25.epro]
2026-07-15 添加 README:项目简介、仓库结构与编译烧录说明
